DINDIN2007/Blystwatch/Dock/Smart-Watch-L15-Dock.kicad_pcb

## KiCad design Dock/Smart-Watch-L15-Dock.kicad_pcb (2026-05-12)

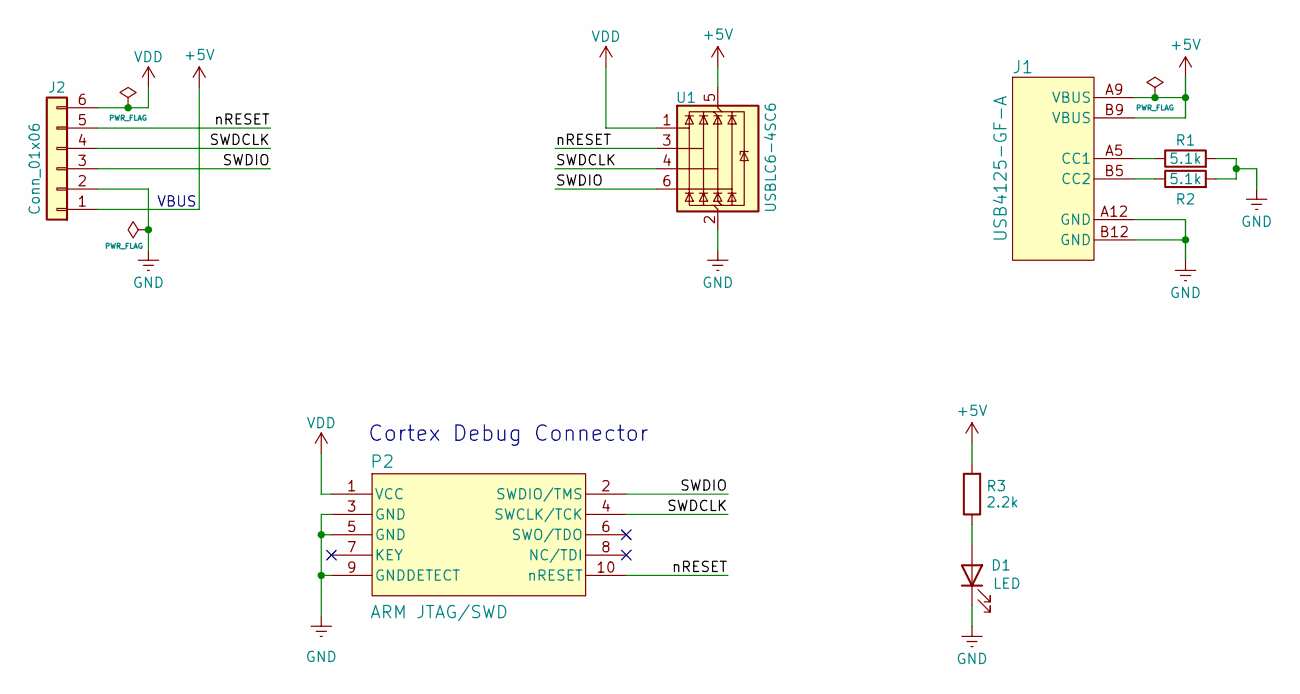
[picture p8: schematic Smart-Watch-L15-Dock.kicad_sch, Blystwatch Dock]

Parts:
D1: LED; LED_0603_1608Metric_Pad1.05x0.95mm_HandSolder
J1: USB4125-GF-A; CONN6_USB4125_GCT
J2: Conn_01x06; PinHeader_1x06_P2.54mm_Vertical
P2: ARM JTAG/SWD; CON10_2X5_DUK_FTSH_SAI-M
R1, R2: 5.1k; R_0805_2012Metric_Pad1.20x1.40mm_HandSolder
R3: 2.2k; R_0805_2012Metric_Pad1.20x1.40mm_HandSolder
U1: USBLC6-4SC6; SOT-23-6

Connections:
+5V: J1.A9 (VBUS), J1.B9 (VBUS), J2.1, R3.2, U1.5 (VBUS)
/SWDCLK: J2.4, P2.4 (SWCLK/TCK), U1.4 (I/O3)
/SWDIO: J2.3, P2.2 (SWDIO/TMS), U1.6 (I/O4)
/nRESET: J2.5, P2.10 (nRESET), U1.3 (I/O2)
GND: D1.1 (K), J1.A12 (GND), J1.B12 (GND), J2.2, P2.3 (GND), P2.5 (GND), P2.9 (GNDDETECT), R1.2, R2.2, U1.2 (GND)
unnamed: D1.2 (A), R3.1
unnamed: J1.A5 (CC1), R1.1
unnamed: J1.B5 (CC2), R2.1
VDD: J2.6, P2.1 (VCC), U1.1 (I/O1)

Notes on the sheet:
VBUS
Cortex Debug Connector

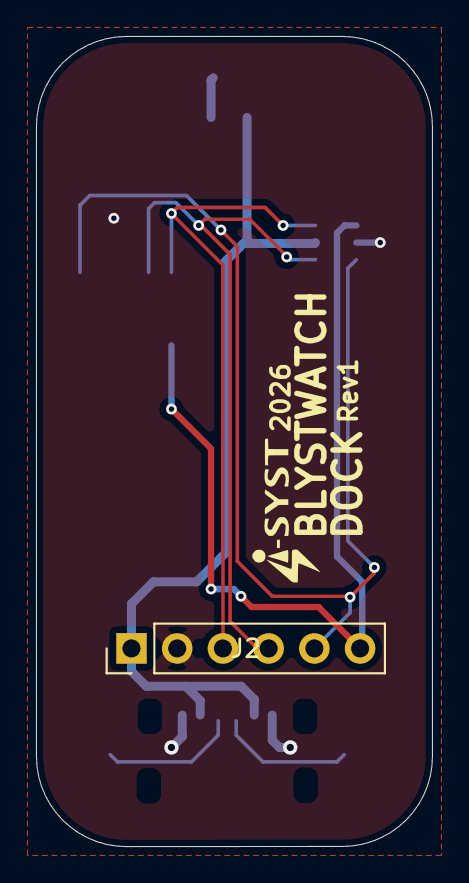
[picture p9: board Smart-Watch-L15-Dock.kicad_pcb from above]

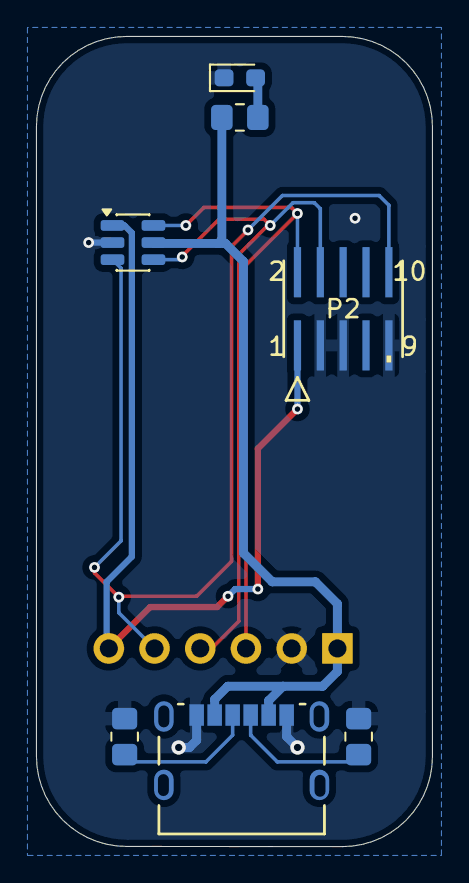
[picture p10: board Smart-Watch-L15-Dock.kicad_pcb from below]

Board: 2 copper layers, 22.0 x 45.0 mm, 8 parts (7 on the bottom side), 9 nets.
